ansinath-10/smart-assistive-cane/evidence/WhatsApp Image 2026-07-02 at 17.15.30.jpeg

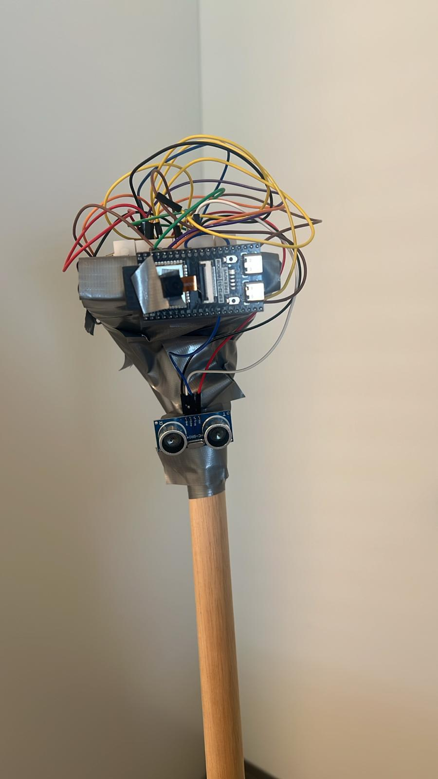
evidence/WhatsApp Image 2026-07-02 at 17.15.30.jpeg
